gfreundl/blinds-actor/jalousie_kicad.pdf

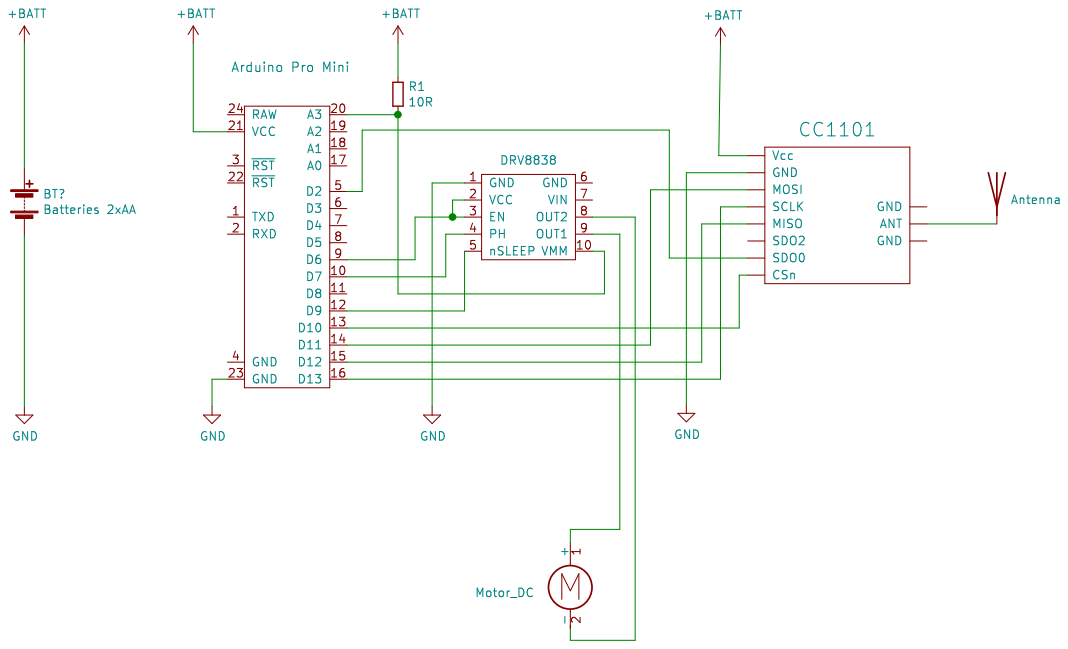
[picture p2: page 1]
